fmaw/CANoBUS/02_hardware/CANoBUS.kicad_sch

## KiCad design 02_hardware/CANoBUS.kicad_sch (2025-04-01)

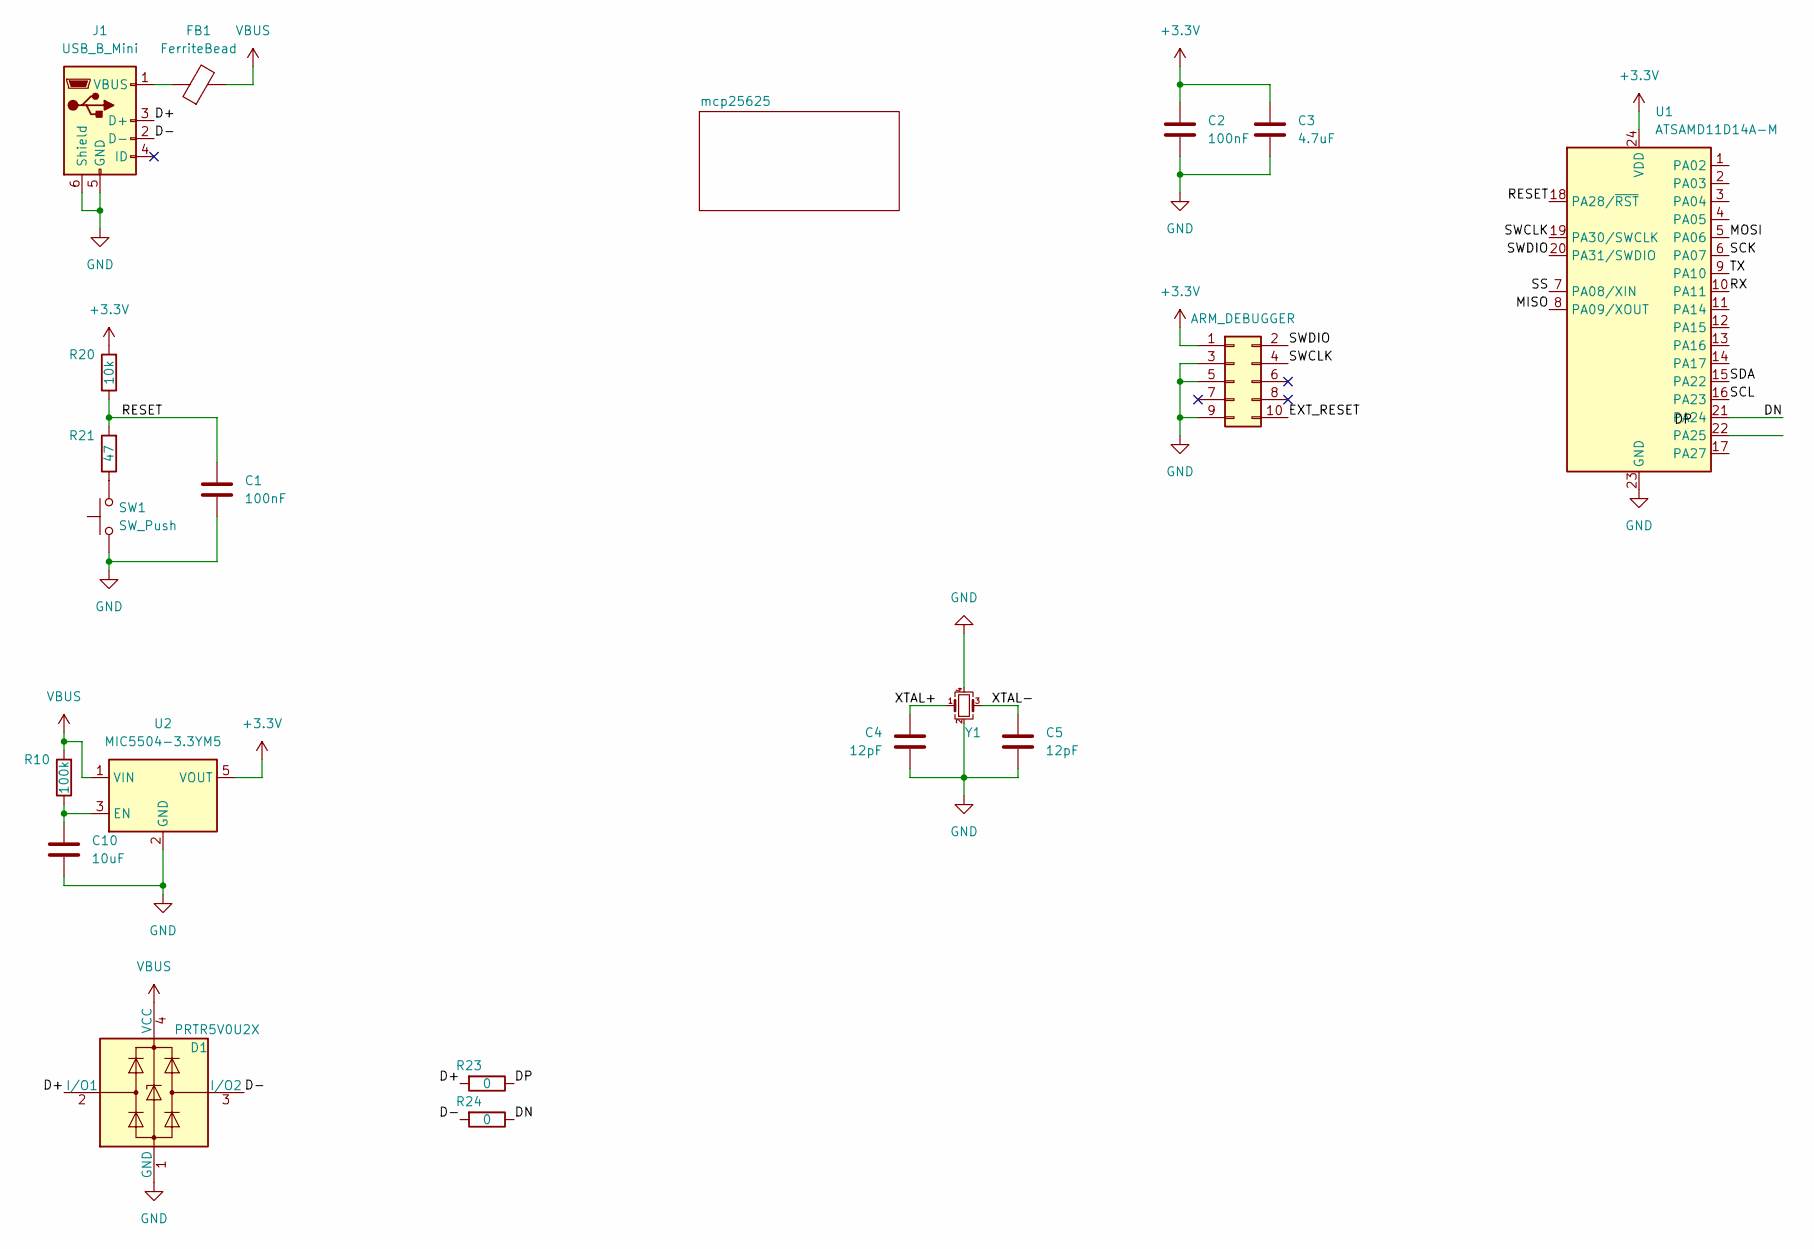
[picture p1: schematic CANoBUS.kicad_sch]

Parts:
ARM_DEBUGGER: Conn_02x05_Odd_Even
C1, C2: 100nF
C3: 4.7uF
C4, C5: 12pF
C10: 10uF
D1: PRTR5V0U2X; SOT-143
FB1: FerriteBead
J1: USB_B_Mini
R10: 100k
R20: 10k
R21: 47
R23, R24: 0
SW1: SW_Push
U1: ATSAMD11D14A-M; QFN-24-1EP_4x4mm_P0.5mm_EP2.6x2.6mm
U2: MIC5504-3.3YM5; SOT-23-5
Y1: Crystal_GND24_Small; Crystal_SMD_3225-4Pin_3.2x2.5mm

Connections:
+3.3V: ARM_DEBUGGER.1, C2.1, C3.1, R20.2, U1.24 (VDD), U2.5 (VOUT)
D+: D1.2 (I/O1), J1.3 (D+), R23.2
D-: D1.3 (I/O2), J1.2 (D-), R24.2
DN: R24.1, U1.21 (PA24)
DP: R23.1
EXT_RESET: ARM_DEBUGGER.10
GND: ARM_DEBUGGER.3, ARM_DEBUGGER.5, ARM_DEBUGGER.9, C1.2, C2.2, C3.2, C4.2, C5.2, C10.2, D1.1 (GND), J1.5 (GND), J1.6 (Shield), SW1.1, U1.23 (GND), U2.2 (GND), Y1.2, Y1.4
MISO: U1.8 (PA09/XOUT)
MOSI: U1.5 (PA06)
unnamed: C10.1, R10.1, U2.3 (EN)
unnamed: FB1.1, J1.1 (VBUS)
unnamed: R21.1, SW1.2
RESET: C1.1, R20.1, R21.2, U1.18 (PA28/~RST)
RX: U1.10 (PA11)
SCK: U1.6 (PA07)
SCL: U1.16 (PA23)
SDA: U1.15 (PA22)
SS: U1.7 (PA08/XIN)
SWCLK: ARM_DEBUGGER.4, U1.19 (PA30/SWCLK)
SWDIO: ARM_DEBUGGER.2, U1.20 (PA31/SWDIO)
TX: U1.9 (PA10)
VBUS: D1.4 (VCC), FB1.2, R10.2, U2.1 (VIN)
XTAL+: C4.1, Y1.1
XTAL-: C5.1, Y1.3
