fmaw/CANoBUS/02_hardware/mcp25625.kicad_sch

## KiCad design 02_hardware/mcp25625.kicad_sch (2025-04-01)

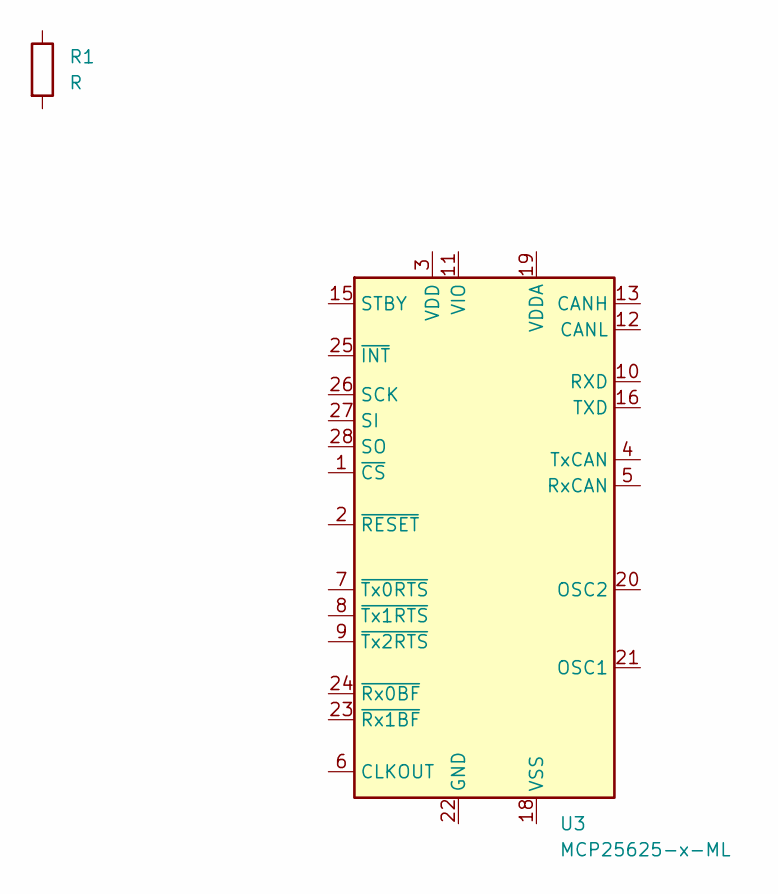
[picture p2: schematic mcp25625.kicad_sch]

Parts:
R1: R
U3: MCP25625-x-ML; QFN-28-1EP_6x6mm_P0.65mm_EP4.25x4.25mm
